fmcetin7/Roketsan-Internship/README.md

# Roketsan-Internship

This repository is created for the work I conducted during my internship at ROKETSAN

Check out my internship report for detailed information
