fmcetin7/Roketsan-Internship/(list of files, drawings)

Other design files:
PA_Test_Kartı_v2.PcbLib
PA_Test_Kartı_v2.SchLib
